nigelfiler/Marine_Water_Meter/pcb/Readme

"SCH_Water-Gauge_2025-03-27.json"  can be opened using easyeda.com and then edited to create your own design
Gerber file "Gerber_Water_Gauge_PCB_Water-Gauge....." -  Can be uploaded to https://jlcpcb.com/ for production of the board based on my design
