nigelfiler/Marine_Water_Meter/Gauge_after1.jpg

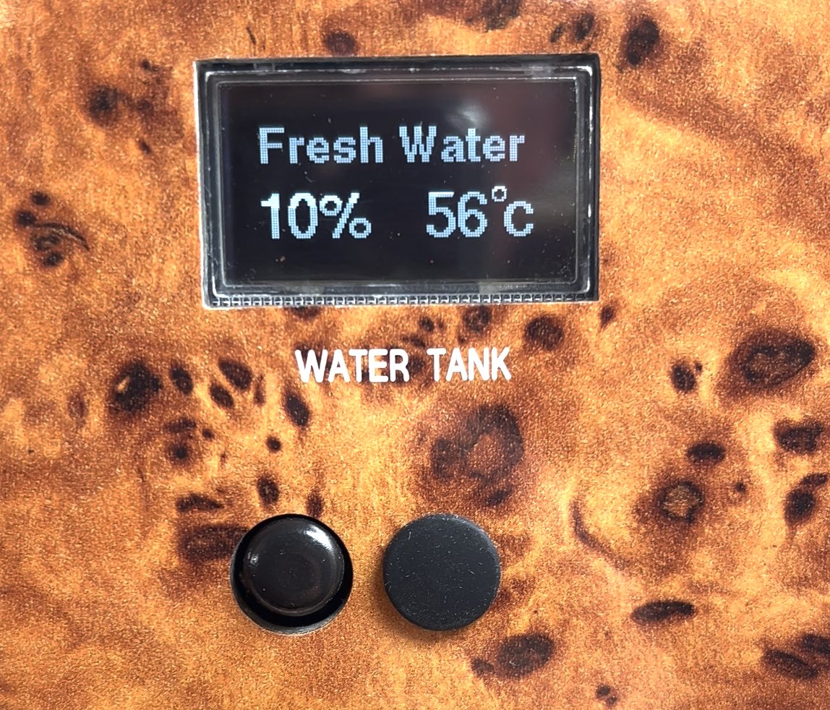
Gauge_after1.jpg
