nigelfiler/Marine_Water_Meter/Gauge_after2.jpg

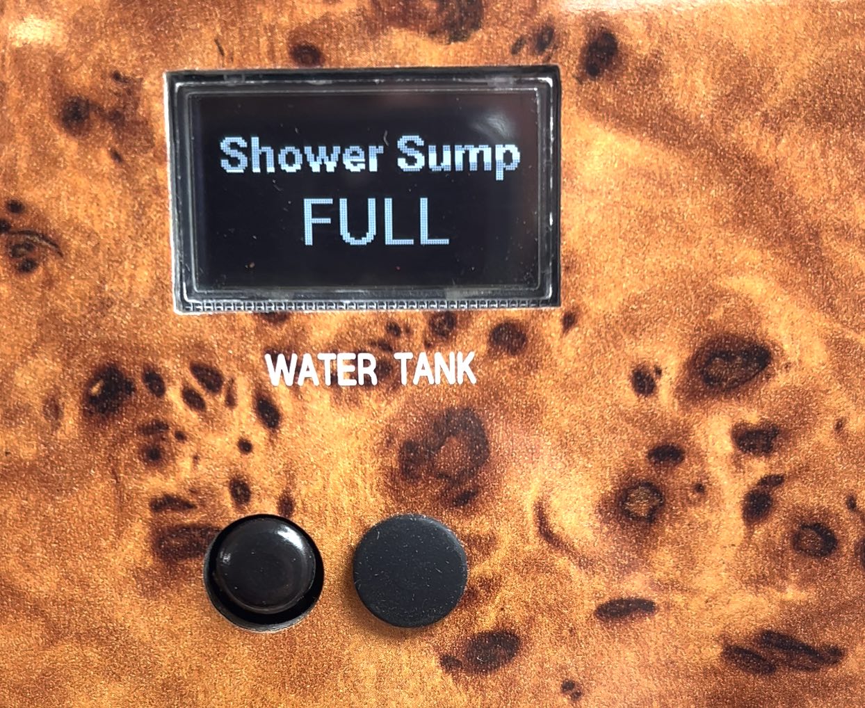
Gauge_after2.jpg
