nigelfiler/Marine_Water_Meter/Gauge_before.JPG

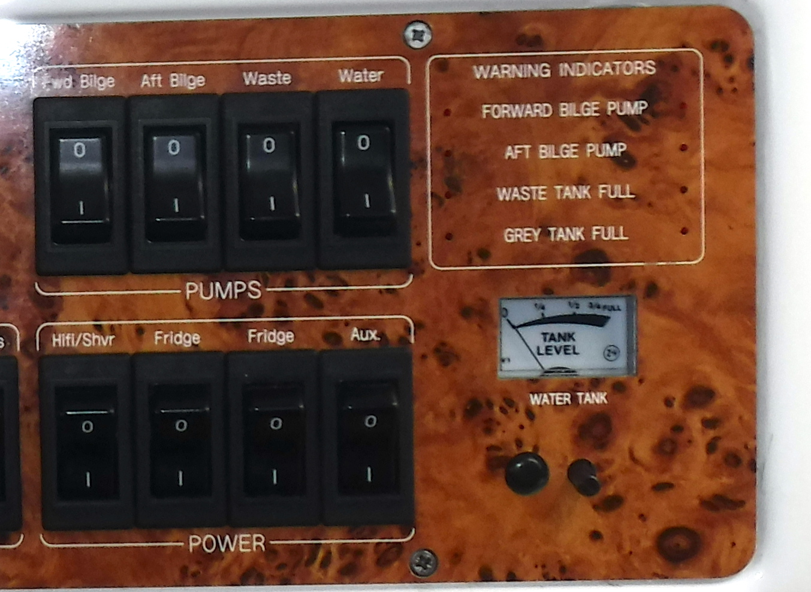
Gauge_before.JPG
