nigelfiler/Marine_Water_Meter/pcb/PCB_Layout.png

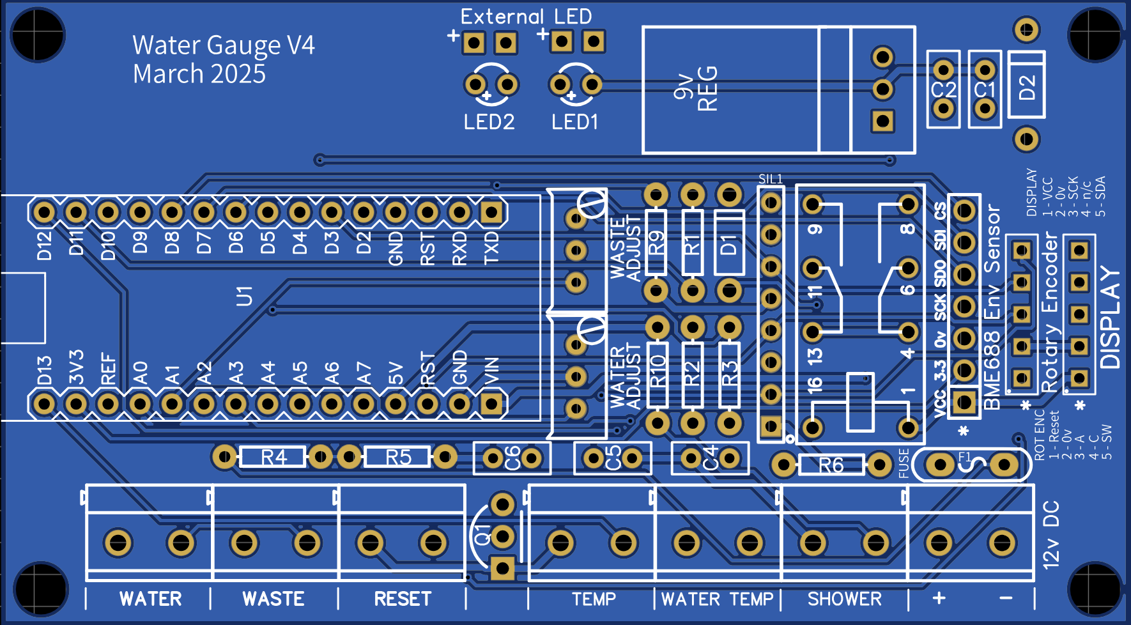
pcb/PCB_Layout.png
