nigelfiler/Marine_Water_Meter/Sump_switch.jpeg

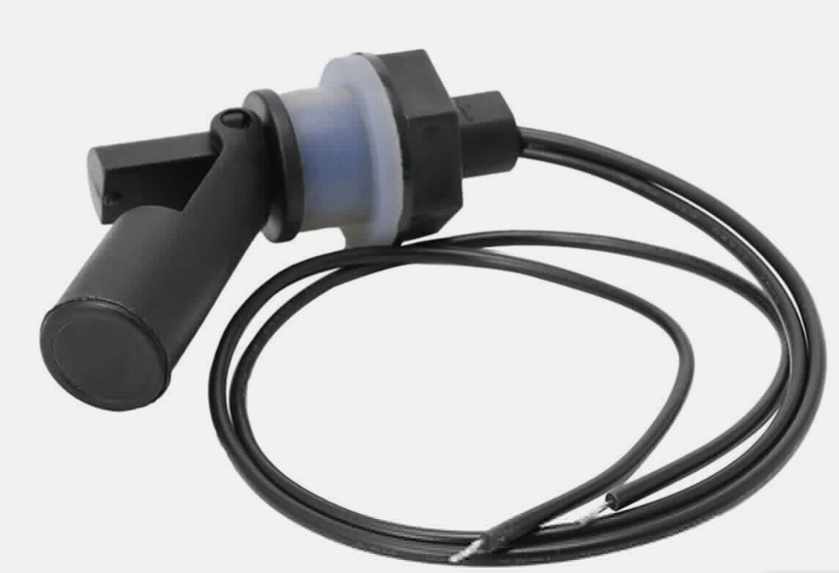
Sump_switch.jpeg
