nigelfiler/Marine_Water_Meter/(list of files, drawings)

Other design files:
pcb/SCH_Water-Gauge_2025-03-27.json
