nigelfiler/Marine_Water_Meter/(commit log)

2025-03-17 Block Diagram showing sensors
    Project uses multiple sensors to check water temperature, shower sump, waste tank and fresh water tank
2025-03-23 Add files via upload
    Easy EDA project file for circuit layout
    [Easyeda-SCH_Water-Gauge_2025-03-23.json]
2025-03-23 Add files via upload
    PCB Layout
2025-03-23 Add files via upload
    Gerber File
2025-03-24 Add files via upload
    Gerber File for PCB production
2025-03-27 Add files via upload
    EasyEDA file. Open file using https://easyeda.com/
    [SCH_Water-Gauge_2025-03-27.json]
2025-03-28 Add files via upload
    Switch to install in the sump box to detect full condition after pump or float switch failure
2025-04-03 Rename PCB Layout.png to PCB_Layout.png
2025-04-15 Photo of assembled PCB
